Yevgeniy-Olexandrenko/tiny-rpn-calculator/hardware/pcb-rev1.x-keyboard/calculation.ods

Vcc | 5
Key | Vmeasure | ADC | Range | Range | Min | Max | Mid
HIGHEST | 4.5 | 921 | to next | to prev
KEY_D3 | 4.43 | 906 | 14 | 25 | 894 | 913 | 903
KEY_C3 | 4.31 | 882 | 25 | 35 | 864 | 893 | 879
KEY_B3 | 4.14 | 847 | 35 | 39 | 828 | 863 | 846
KEY_A3 | 3.95 | 808 | 39 | 90 | 763 | 827 | 795
KEY_D2 | 3.51 | 718 | 90 | 51 | 693 | 762 | 727
KEY_C2 | 3.26 | 667 | 51 | 61 | 636 | 692 | 664
KEY_B2 | 2.96 | 606 | 61 | 63 | 574 | 635 | 605
KEY_A2 | 2.65 | 542 | 63 | 72 | 506 | 573 | 540
KEY_D1 | 2.3 | 471 | 72 | 55 | 443 | 505 | 474
KEY_C1 | 2.03 | 415 | 55 | 63 | 384 | 442 | 413
KEY_B1 | 1.72 | 352 | 63 | 53 | 325 | 383 | 354
KEY_A1 | 1.46 | 299 | 53 | 57 | 270 | 324 | 297
KEY_D0 | 1.18 | 241 | 57 | 39 | 222 | 269 | 246
KEY_C0 | 0.99 | 203 | 39 | 39 | 183 | 221 | 202
KEY_B0 | 0.8 | 164 | 39 | 31 | 148 | 182 | 165
KEY_A0 | 0.65 | 133 | 31 | 31 | 118 | 147 | 132
LOWEST | 0.5 | 102
