Yevgeniy-Olexandrenko/tiny-rpn-calculator/hardware/pcb-rev1.4/Tiny-RPN-Calculator-rev1.4_BOM.tsv

ID | Name | Designator | Footprint | Quantity | Manufacturer Part | Manufacturer | Supplier | Supplier Part
1 | 1k | R4,R15,R10,R9 | R0603 | 4 | 0603WAF1001T5E | UniOhm | LCSC | C21190
2 | 51k | R14 | R0603 | 1 | 0603WAF5102T5E | UniOhm | LCSC | C23196
3 | 820R | R11 | R0603 | 1 | 0603WAF8200T5E | UniOhm | LCSC | C23253
4 | 560R | R12 | R0603 | 1 | 0603WAF5600T5E | UniOhm | LCSC | C23204
5 | 2k2 | R13 | R0603 | 1 | 0603WAF2201T5E | UniOhm | LCSC | C4190
6 | 680R | R5 | R0603 | 1 | 0603WAF6800T5E | UniOhm | LCSC | C23228
7 | 1k2 | R6 | R0603 | 1 | 0603WAF1201T5E | UniOhm | LCSC | C22765
8 | 3k3 | R7 | R0603 | 1 | 0603WAF3301T5E | UniOhm | LCSC | C22978
9 | 12k | R8 | R0603 | 1 | 0603WAF1202T5E | UniOhm | LCSC | C22790
10 | CHRG | LED | LED0603_RED | 1 | 19-217/R6C-AL1M2VY/3T | EVERLIGHT | LCSC | C72044
11 | 1u | C6,C5,C3,C4 | C0603 | 4 | CL10A105KB8NNNC | SAMSUNG | LCSC | C15849
12 | XC6206P332MR | U1 | SOT-23-3_L2.9-W1.6-P1.90-LS2.8-BR | 1 | XC6206P332MR | TOREX | LCSC | C5446
13 | U253-051N-4BH85-SB | USB | MICRO-USB-SMD_U253-051T-4BH85-SB | 1 | U253-051N-4BH85-SB | XKB Enterprise | LCSC | C319177
14 | MCP73831T-2ATI/OT | U2 | SOT-23-5_L3.0-W1.7-P0.95-LS2.8-BR | 1 | MCP73831T-2ATI/OT | MICROCHIP | LCSC | C14879
15 | DS3231MZ+ | RTC | SOIC-8_L4.9-W3.9-P1.27-LS6.0-BL | 1 | DS3231MZ+ | MAXIM | LCSC | C107410
16 | 100n | C7,C8 | C0603 | 2 | CC0603KRX7R9BB104 | YAGEO | LCSC | C14663
17 | 4u7 | C9,C10,C2 | C0603 | 3 | CL10A475KO8NNNC | SAMSUNG | LCSC | C19666
18 | 390k | R1 | R0603 | 1 | 0603WAF3903T5E | UniOhm | LCSC | C23150
19 | 4k7 | R2,R3 | R0603 | 2 | 0603WAF4701T5E | UniOhm | LCSC | C23162
20 | ATTINY85-20SU | MCU | SOIC-8_L5.3-W5.3-P1.27-LS8.0-BL | 1 | ATTINY85-20SU | MICROCHIP | LCSC | C89852
21 | 2u2 | C1 | C0603 | 1 | CL10A225KO8NNNC | SAMSUNG | LCSC | C23630
22 | SSD1306 128X32 | OLED | OLED-0.91 BARE | 1
23 | 3x6x2.5 | BTN_A0,BTN_A1,BTN_A2,BTN_A3,BTN_B0,BTN_B2,BTN_B3,BTN_B1,BTN_C0,BTN_C1,BTN_C2,BTN_C3,BTN_D0,BTN_D1,BTN_D2,BTN_D3 | KEY-3.0*6.0 | 16 | TS3625A-HT | SHOU HAN | LCSC | C412368
