Yevgeniy-Olexandrenko/tiny-rpn-calculator/documents/howto-build/howto-build.md

# How to Build the Business Card RPN Calculator with Watch

## Step 1 - TODO

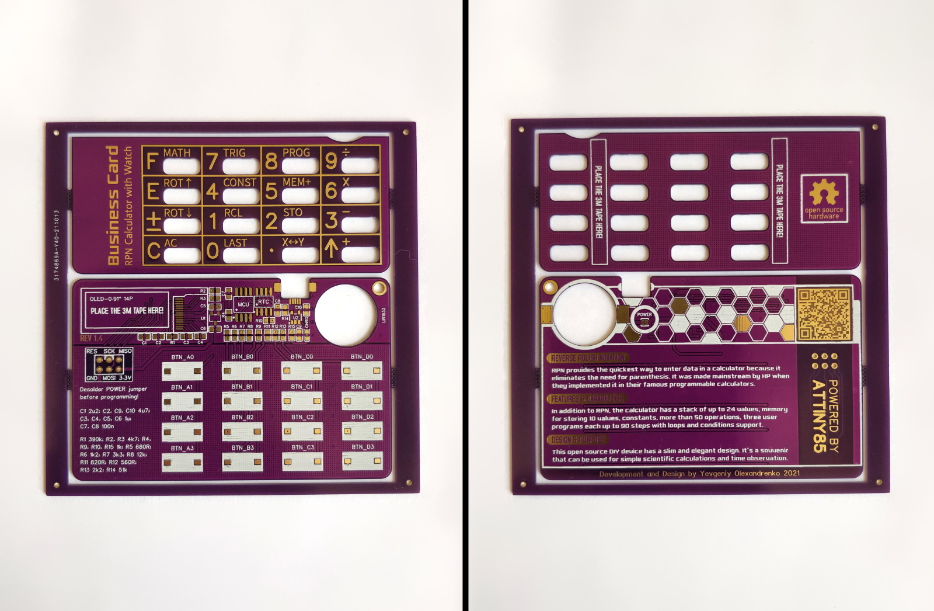
[picture p2: documents/howto-build/step1.jpg]
Step 1


## Step 2 - TODO

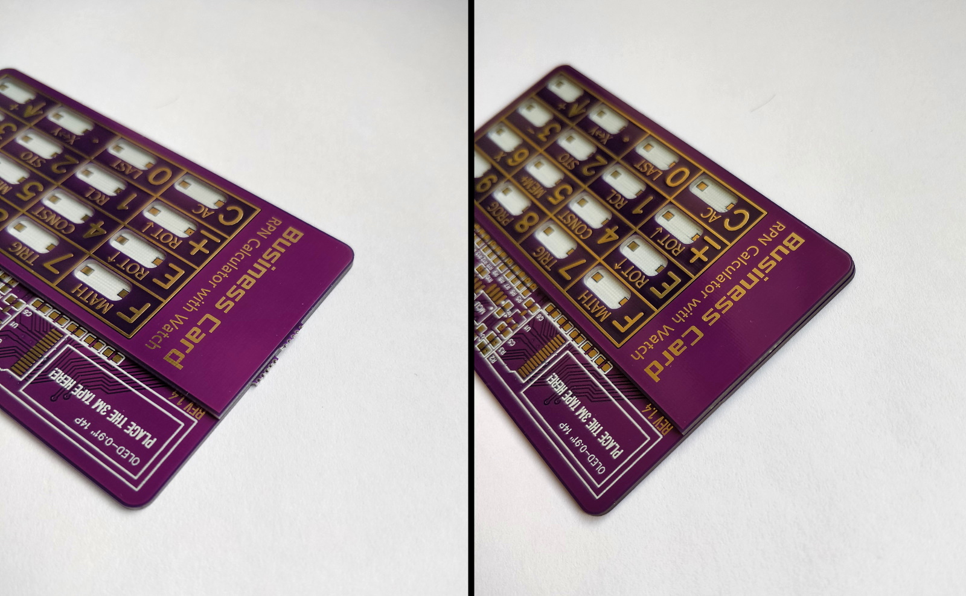
[picture p3: documents/howto-build/step2.jpg]
Step 2


## Step 3 - SMD Components

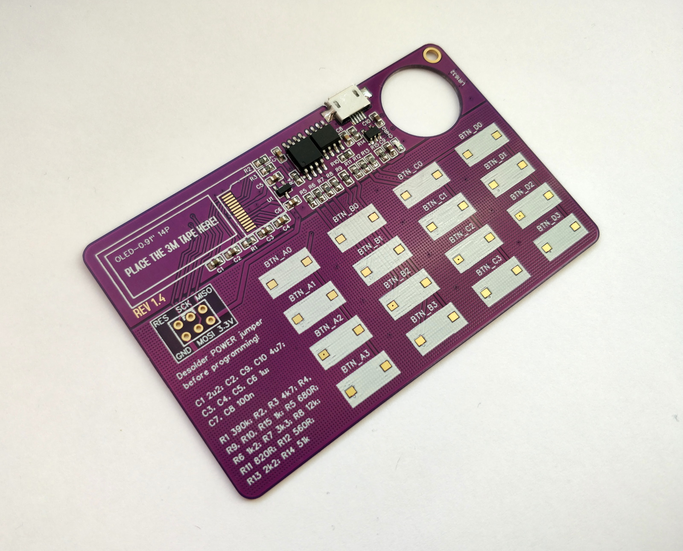
[picture p4: documents/howto-build/step3.jpg]
Step 3


## Step 4 - Buttons

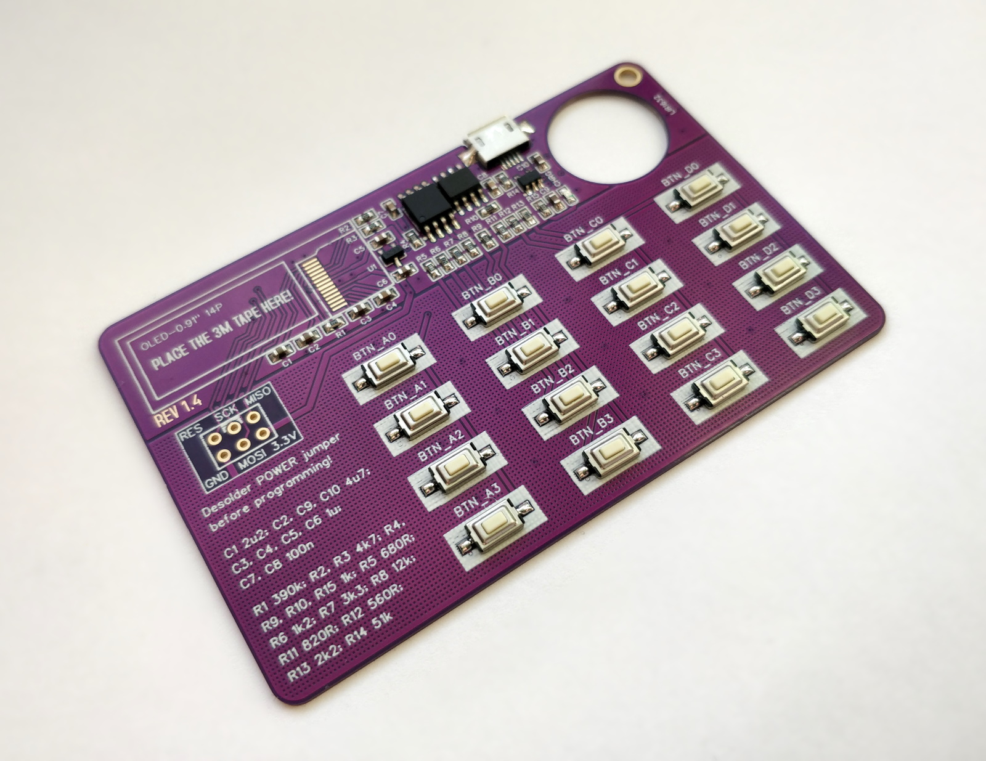
[picture p5: documents/howto-build/step4.jpg]
Step 4


## Step 5 - Battery

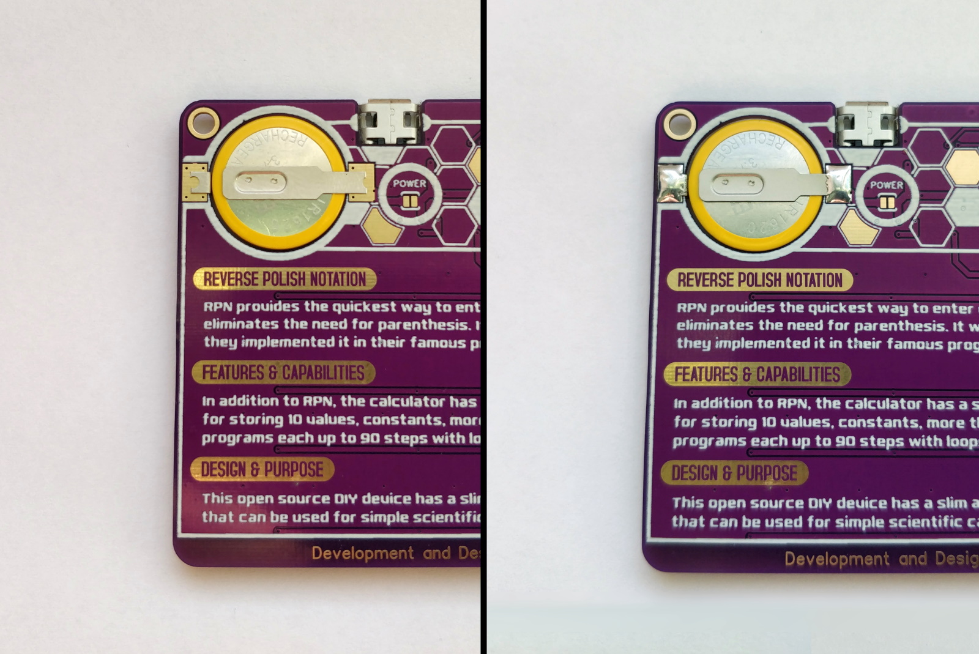
[picture p6: documents/howto-build/step5.jpg]
Step 5


## Step 6 - Display

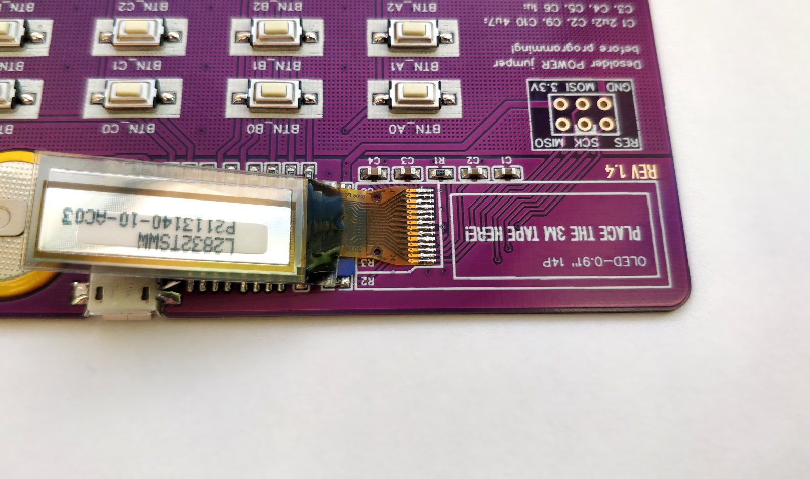
[picture p7: documents/howto-build/step6.jpg]
Step 6


## Step 7 - Ultra-thin 3M tape

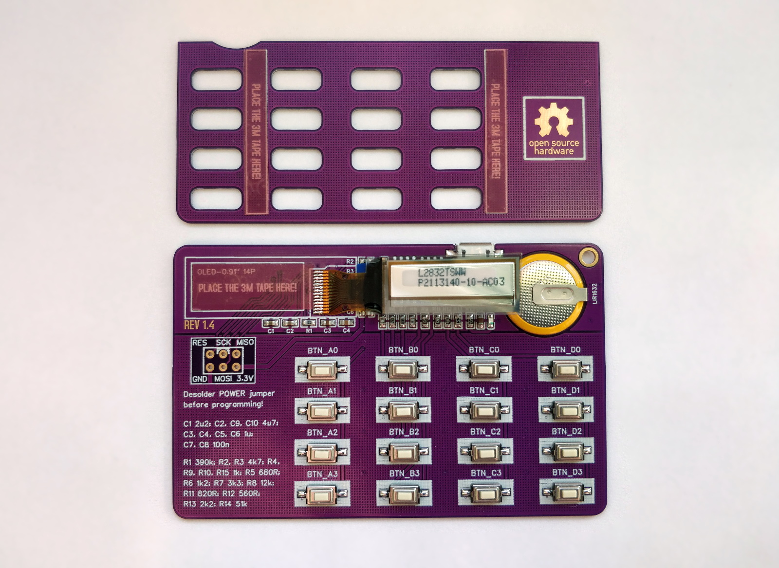
[picture p8: documents/howto-build/step7.jpg]
Step 7


## Step 8 - Programming

Write the firmware to the device. Refer to [HP-35 Firmware — User Manual](../manuals/hp35-firmware-user-manual.md#14-firmware-installation), section 14.

## Step 9 - Finished Device

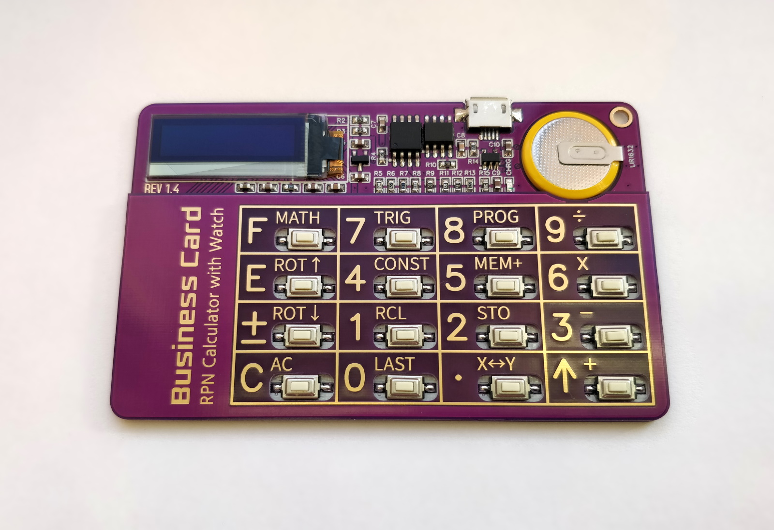
[picture p9: documents/howto-build/step9.jpg]
Step 9
