Yevgeniy-Olexandrenko/tiny-rpn-calculator/documents/manuals/images/hp35-device.jpg

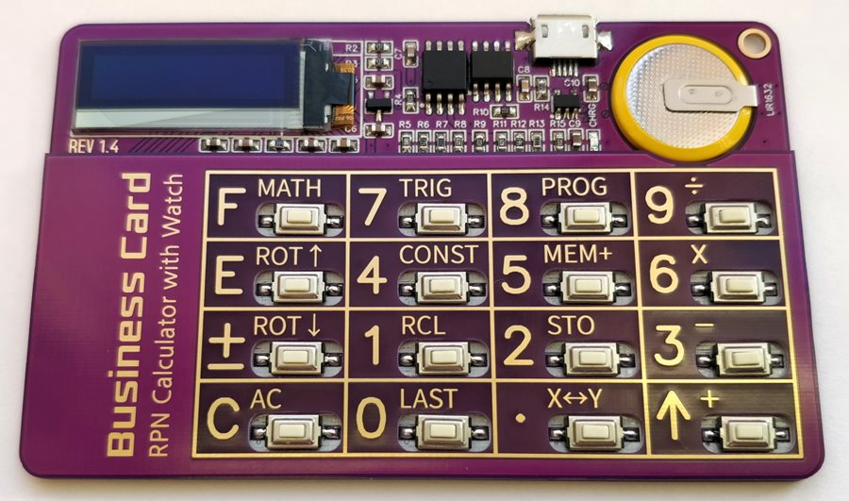
documents/manuals/images/hp35-device.jpg
