Yevgeniy-Olexandrenko/tiny-rpn-calculator/documents/manuals/images/hp35-keyboard.jpg

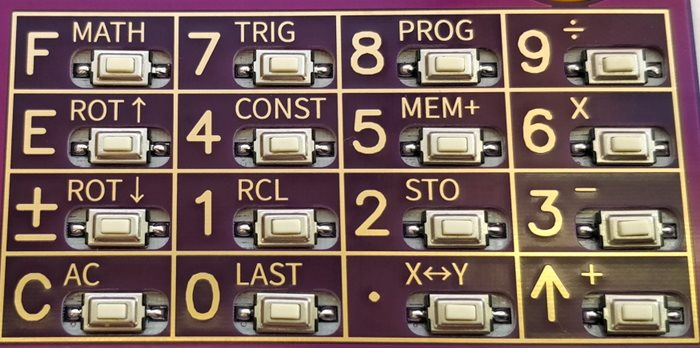
documents/manuals/images/hp35-keyboard.jpg
