Yevgeniy-Olexandrenko/tiny-rpn-calculator/hardware/pcb-rev1.5/Tiny-RPN-Calculator-rev1.5_Schematic.pdf

# Charger

# ICSP

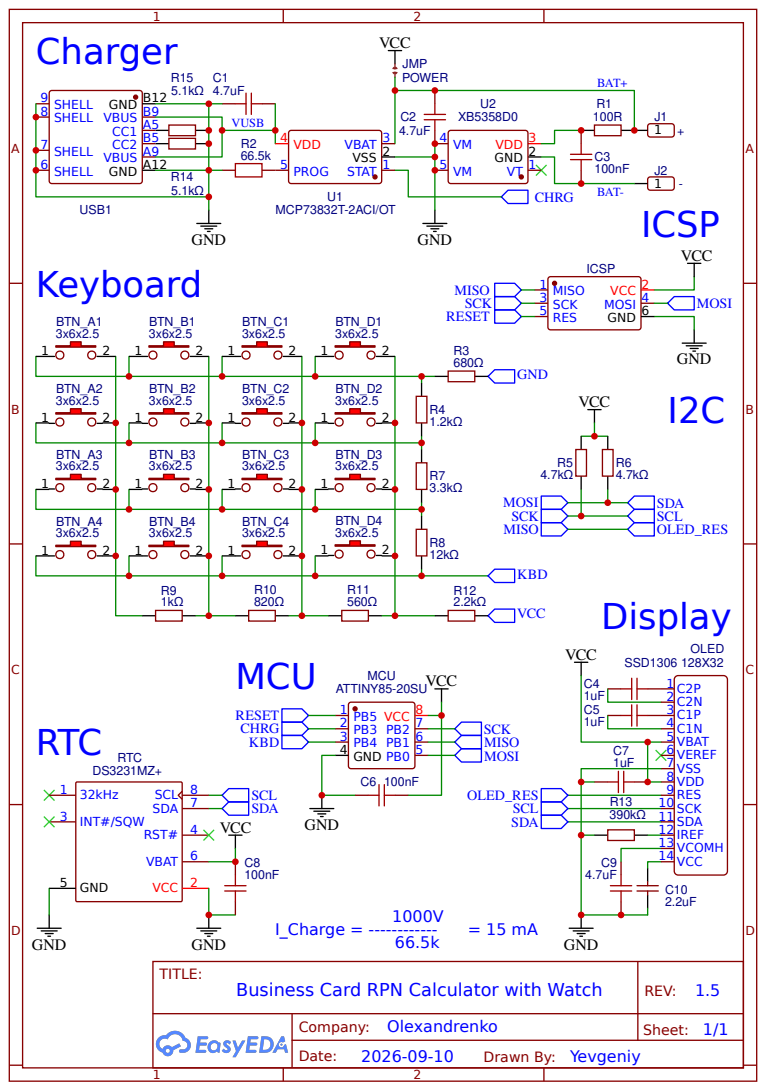
[picture p12: page 1]

STAT 1 VSS 2 VBAT 3 VDD 4
PROG 5 ⁶⁶.5k
