Yevgeniy-Olexandrenko/tiny-rpn-calculator/hardware/pcb-rev1.4/Tiny-RPN-Calculator-rev1.4_Schematic.pdf

# Keyboard

# Display

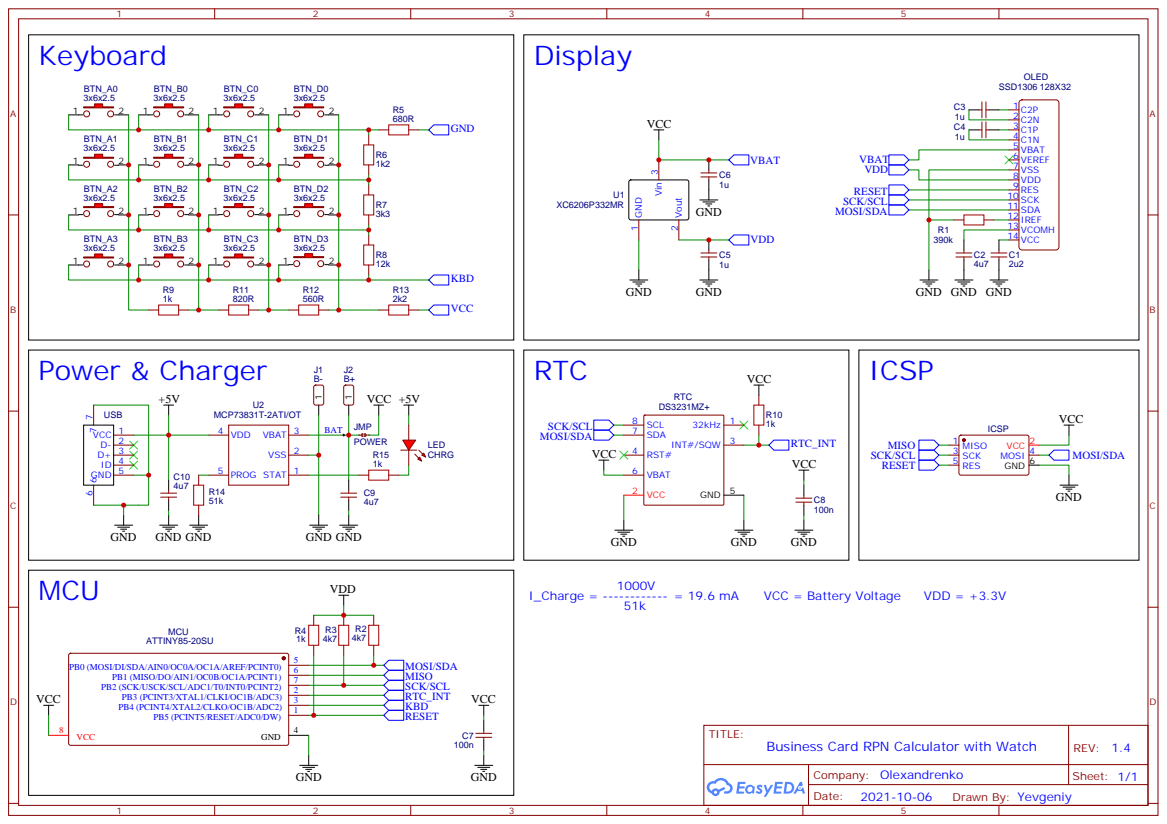
[picture p13: page 1]

PB0 (MOSI/DI/SDA/AIN0/OC0A/OC1A/AREF/PCINT0)
