Yevgeniy-Olexandrenko/tiny-rpn-calculator/hardware/pcb-rev1.3/Tiny-RPN-Calculator-rev1.3_Schematic.pdf

# Keyboard

# Display

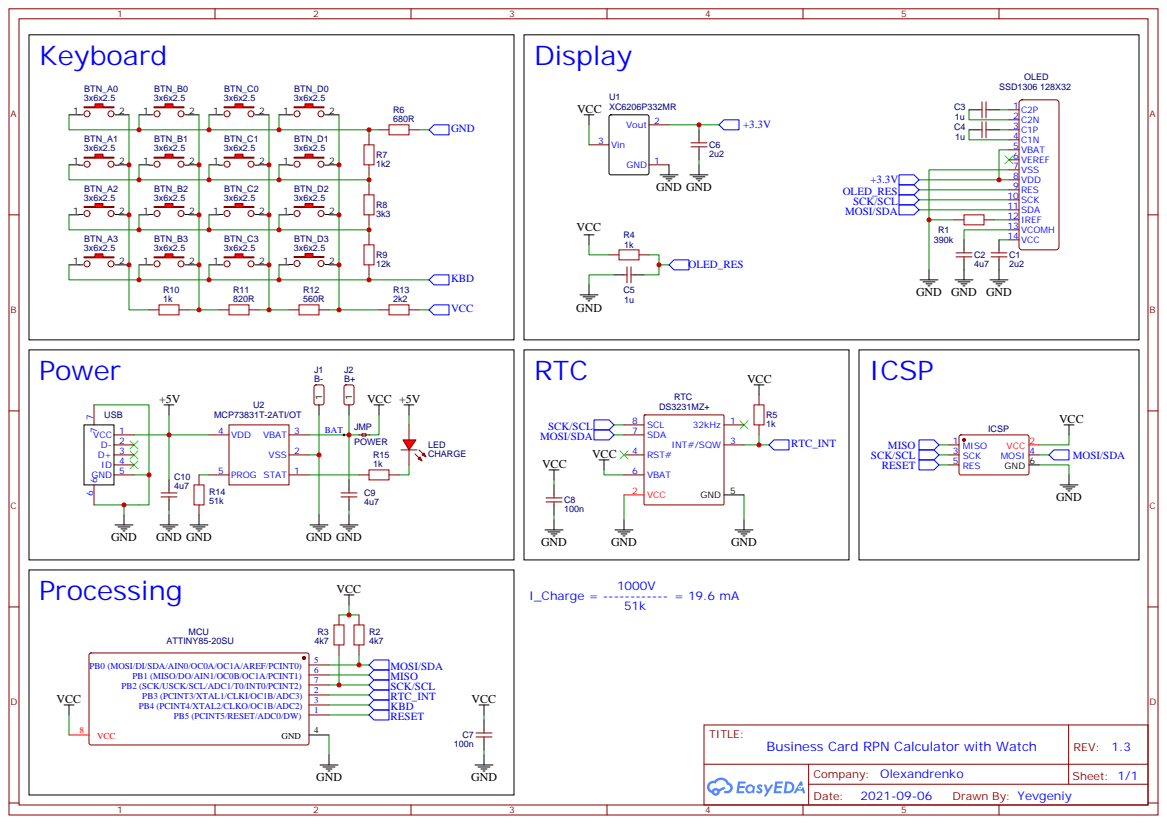
[picture p14: page 1]

PB0 (MOSI/DI/SDA/AIN0/OC0A/OC1A/AREF/PCINT0)
