Yevgeniy-Olexandrenko/tiny-rpn-calculator/(list of files, drawings)

Other design files:
hardware/pcb-rev1.x-keyboard/simulation.pdsprj
