Yevgeniy-Olexandrenko/tiny-rpn-calculator/firmware/sketches/hp21/code.h

#pragma once

// -----------------------------------------------------------------------------
// Working mode and keyboard input, shared by all modes
// -----------------------------------------------------------------------------

enum { MODE_RTC, MODE_CALC };
u08 mode;

u08 newKey;
u08 oldkey;

// slow mode (RTC) redraws every 512 ms only, so the mcu sleeps
// most of the time, while the keys are still read every frame
u08 slowPhase; // TMR::Millis / 512 at the last redraw, 0xFF forces one

b08 slowRedraw()
{
	u08 phase = u08(TMR::Millis >> 9);
	if (phase == slowPhase) return false;
	slowPhase = phase;
	return true;
}

// -----------------------------------------------------------------------------
// RTC mode
// -----------------------------------------------------------------------------

u08 battery;

void renderRTCMode()
{
	LCD::Clear();

	TXT::SetFont(digits7x32);
	TXT::PrintChar(RTC_TIME_COLON, RTC_POS_COLON_HM, 0);
	TXT::PrintChar(RTC_TIME_COLON, RTC_POS_COLON_MS, 0);
	TXT::PrintSegBCD(RTC::Hours,   RTC_POS_HOURS, 0);
	TXT::PrintSegBCD(RTC::Minutes, RTC_POS_MINUTES, 0);
	TXT::PrintSegBCD(RTC::Seconds, RTC_POS_SECONDS, 0);

	TXT::SetFont(menu5x8);
	u08 month = BCD::Decode(RTC::Month);
	TXT::PrintString(DPSTR(strMonth), month - 1, RTC_POS_MONTH, 0);
	TXT::PrintBCD(RTC::Date, RTC_POS_DATE, 0);
	TXT::PrintBCD(RTC::Year, RTC_POS_YEAR, 0);
	TXT::PrintChar(RTC_DATE_SLASH, RTC_POS_SLASH, 0);

	TXT::SetScale(TXT::x2, TXT::x1);
	TXT::PrintString(D(RTC_INFO_HP_LABEL), RTC_POS_INFO, 2);
	// blink the last bar while charging, toggling it every 512 ms,
	// with an empty battery one bar blinks
	u08 bars = battery;
	if ((TMR::Millis & 0x200) && PWR::Charging()) bars = (bars ? bars - 1 : 1);
	for (u08 i = bars, x = RTC_POS_INFO; i > 0; --i)
	{ 
		TXT::PrintChar(RTC_BATTERY_LEVEL, x, 1);
		TXT::NextPos(x);
	}

	LCD::Flip();
}

// returns false if a key is pressed to leave the mode
b08 updateRTCMode()
{
	if (newKey != KBD::NONE) return false;
	if (slowRedraw())
	{
		RTC::ReadTimeDate();
		renderRTCMode();
	}
	return true;
}

void enterRTCMode()
{
	battery = (u08)((PWR::Level() + 10U) / 20U); // 0..100% -> 0..5 bars

	SYS::Wake(TMR::TIMEOUT_64MS);

	oldkey    = KBD::Read();
	slowPhase = 0xFF;
	mode      = MODE_RTC;
}

NOINLINE
void setupAndEnterRTCMode()
{
	RTC::WriteTimeDate();
	enterRTCMode();
}

// -----------------------------------------------------------------------------
// Calculator mode
// -----------------------------------------------------------------------------

b08 isFunc;
b08 isMenu;
b08 isMem; // storage arithmetic: the next key selects the operation with M1
b08 powerOff; // OFF: power down in the next frame, the calculator starts again

Menu menu;
u08  select;

u16 cycles;
u08 hidden[sizeof(HPVM::Display)];
u08 lastOp = KEY_NOP; // nothing to repeat before the first menu or storage arithmetic operation

void enterMenu(u08 type)
{
	isMenu = true;
	MEM::ProgCopy(&menu, &menus[type], sizeof(Menu));
	select = 0;
}

void dropStack(u08 n)
{
	using namespace HPVM;
	// roll down via ROM to end number entry and refresh display,
	// then restore T to get a drop: C, Y, Z <- Y, Z, T
	do
	{
		OpAndWait(OpROT_);
		reg_move(T, Z, 0, 13, COPY);
	}
	while (--n);
}

b08 getBCD(const HPVM::reg& r, u08& out, u08 min, u08 max)
{
	// positive integer 0..999: mantissa sign, exponent sign and
	// exponent tens are zero, exponent units 0..2, digits of the
	// mantissa after the integer part are zero (no fraction)
	if ((r[13] | r[2] | r[1]) == 0 && r[0] < 3)
	{
		u08 last = 12 - r[0]; // the lowest digit of the integer part
		u16 value = 0;
		for (u08 i = 12; i > 2; --i)
		{
			if (i >= last)
				value = value * 16 + r[i];
			else if (r[i])
				return false;
		}
		if (value >= min && value <= max)
		{
			out = u08(value);
			return true;
		}
	}
	return false;
}

// the integer part of a number in the register layout: the digits of the
// mantissa after the decimal point are cleared, a number below 1 is zero
void truncate(HPVM::reg& r)
{
	// the exponent: sign digit r[2] (9 if negative), digits r[1] r[0]
	if (r[2])
		memset(r, 0, sizeof(HPVM::reg)); // below 1
	else if (!r[1])
		// exponent 0..9: the integer part has r[0] + 1 digits of 12..3
		for (u08 i = 11 - r[0]; i > 2; --i) r[i] = 0;
}

// lifts Y to Z, puts r into Y and lets the ROM do the operation with Y
// and X; the operation drops the stack again, so Y, Z, T do not change
// (T is kept by the drop, as it is a copy of Z after a division)
NOINLINE
void operationWithY(const HPVM::reg& r, u08 op)
{
	using namespace HPVM;
	memcpy(Z, Y, sizeof(reg));
	memcpy(Y, r, sizeof(reg));
	OpAndWait(op);
}

// Y mod X = Y - X * INT(Y / X), the ROM does the arithmetic, the sketch the
// integer part and the operands; the remainder gets the sign of X (as MOD of
// the HP-42S: -7 mod 3 = 2), the stack drops as after a division
void moduloYX()
{
	using namespace HPVM;
	reg x, y;
	memcpy(x, C, sizeof(reg));
	memcpy(y, Y, sizeof(reg));

	// for X = 0 the ROM shows the error of the division; Y / X of 10^9
	// or more has no digit after the decimal point in 10 digits, so the
	// remainder is lost
	OpAndWait(OpDIV_);
	if (!x[12]) return;
	if (!C[2] && (C[1] || C[0] >= 9))
	{
		Error();
		return;
	}

	truncate(C);
	operationWithY(x, OpMUL_);
	operationWithY(y, OpSUB_);
	if (C[12] && C[13] != x[13]) operationWithY(x, OpADD_);
}

void executeOperation(u08 operation)
{
	// the sketch reads and changes the registers of the VM directly,
	// so the previous operation must be finished first
	HPVM::WaitIdle();

	isFunc = false;
	isMenu = false;
	isMem  = false;
	// repeat the last menu or storage arithmetic operation, extended ones too
	if (operation == KEY_LAST) operation = lastOp;

	switch (operation)
	{
		default:
			// a constant of the CONST menu, otherwise a key of the ROM
			if (operation >= CONST_IN && operation <= CONST_E)
				HPVM::Constant(constants[CONST_E - operation]);
			else
				HPVM::Operation(operation);
			break;

		case KEY_FUNC:
			HPVM::DisplayY(hidden);
			isFunc = true;
			break;

		case KEY_MEM:
			isMem = true;
			break;

		case MEM_SWAP:
			// a number entered after it lifts the stack, as after RCL
			HPVM::ExchangeX(HPVM::M1);
			break;

		case MATH_SQR:
			// X * X, as ENTER and * on the HP-21: Y and Z are kept,
			// T gets a copy of Z
			HPVM::Operation(HPVM::OpPUSH);
			HPVM::Operation(HPVM::OpMUL_);
			break;

		case MATH_ROOT:
		{
			// Y ^ (1 / X); for X = 0 only 1/x, so the ROM shows its error,
			// Y ^ X of the ROM would continue after the error with 1.00;
			// X is normalized: it is zero if its first mantissa digit is
			b08 isZero = (HPVM::C[12] == 0);
			HPVM::Operation(HPVM::OpINV_);
			if (!isZero) HPVM::Operation(HPVM::OpPOW_);
			break;
		}

		case MATH_MOD:
			moduloYX();
			break;

		case KEY_ROTU:
			HPVM::Operation(HPVM::OpROT_);
			HPVM::Operation(HPVM::OpROT_);
			HPVM::Operation(HPVM::OpROT_);
			break;

		// DEG/RAD switch is wired to the F2 flag input
		case PROG_DEG:
			HPVM::F2 = false;
			break;

		case PROG_RAD:
			HPVM::F2 = true;
			break;

		case PROG_OFF:
			powerOff = true;
			break;

		case MENU_MATH:
		case MENU_TRIG:
		case MENU_PROG:
		case MENU_CONST:
			// the menu operations go down in the order of the menus
			enterMenu(MENU_MATH - operation);
			break;

		case PROG_TIME:
			// stack: X - seconds, Y - minutes, Z - hours, the values are
			// dropped if all are valid, otherwise the error is shown
			RTC::ReadTimeDate();
			if (getBCD(HPVM::C, RTC::Seconds, 0x00, 0x59) &&
			    getBCD(HPVM::Y, RTC::Minutes, 0x00, 0x59) &&
			    getBCD(HPVM::Z, RTC::Hours,   0x00, 0x23))
			{
				dropStack(3);
				setupAndEnterRTCMode();
			}
			else HPVM::Error();
			break;

		case PROG_DATE:
			// stack: X - year, Y - month, Z - date, the date is checked
			// against the days in the month, leap years included
			RTC::ReadTimeDate();
			if (getBCD(HPVM::C, RTC::Year,  0x00, 0x99) &&
			    getBCD(HPVM::Y, RTC::Month, 0x01, 0x12) &&
			    getBCD(HPVM::Z, RTC::Date,  0x01, 0x31) &&
			    BCD::Decode(RTC::Date) <= RTC::GetDaysInMonth())
			{
				dropStack(3);
				setupAndEnterRTCMode();
			}
			else HPVM::Error();
			break;

		case KEY_NOP:
			break;
	}
}

void renderCalcNumber(const u08 * segs, u08 y)
{
	// the exponent is in positions 9..11 (sign, 2 digits): then the sign
	// position is blank or a dash, a mantissa digit is never there; as on
	// hp35, the exponent is drawn by the small font in the last 3 cells
	u08 sign = segs[9];
	b08 isExp = (sign == TXT::SEG_SPACE || sign == TXT::SEG_DASH) && (segs[10] | segs[11]);

	// the dot is a part of the display position, but drawn as a separate char
	for (u08 i = 0, x = 0; i < sizeof(HPVM::Display); ++i)
	{
		if (i == 9 && isExp)
		{
			TXT::SetFont(digits7x16);
			x = CALC_POS_EXPONENT;
		}
		u08 seg = segs[i];
		TXT::PrintSeg(seg & ~TXT::SEG_DOT, x, y);
		TXT::NextPos(x);
		if (seg & TXT::SEG_DOT)
		{
			TXT::PrintSeg(TXT::SEG_DOT, x, y);
			TXT::NextPos(x);
		}
	}
}

void renderCalcMenu()
{
	TXT::SetFont(menu5x8);
	TXT::SetScale(TXT::x1, TXT::x2);
	TXT::SetInverse(true);
	for (u08 i = 0; i < MENU_ITEMS_PER_LINE; ++i)
	{
		TXT::PrintString(
			DPSTR(menu.string), select * MENU_ITEMS_PER_LINE + i,
			MENU_POS_ITEM * i, 2);
	}
	TXT::SetInverse(false);
}

void renderCalcMode()
{
	LCD::Clear();
	TXT::SetFont(digits7x16);

	// indicators at the right edge: the top place shows F, else S in the
	// storage arithmetic mode, else R, else S in a menu (the menu covers
	// the bottom place), the bottom place shows S out of these two modes
	b08 isStorage = false;
	for (u08 i = 0; i < sizeof(HPVM::M1); ++i)
	{
		if (HPVM::M1[i]) isStorage = true;
	}
	if (isFunc)
		TXT::PrintChar(FLAG_FUNCTION, FLAG_POS, 0);
	else if (isMem)
		TXT::PrintChar(FLAG_STORAGE, FLAG_POS, 0);
	else if (HPVM::F2)
		TXT::PrintChar(FLAG_RADIANS, FLAG_POS, 0);
	else if (isMenu && isStorage)
		TXT::PrintChar(FLAG_STORAGE, FLAG_POS, 0);
	if (!isMenu && !isMem && isStorage)
		TXT::PrintChar(FLAG_STORAGE, FLAG_POS, 2);

	if (isFunc)
	{
		renderCalcNumber(hidden, 0);
		renderCalcNumber(HPVM::Display, 2);
	}
	else if (isMenu)
	{
		renderCalcNumber(HPVM::Display, 0);
		renderCalcMenu();
	}
	else
	{
		TXT::SetFont(digits7x32);
		renderCalcNumber(HPVM::Display, 0);
	}
	
	LCD::Flip();
}

void updateCalcMode()
{
	if (newKey != KBD::NONE)
	{
		if (isMenu)
		{
			switch(newKey)
			{
				default: isMenu = false; break;
				case KBD::ROTU: if (select > 0) select--; else select = menu.lastIdx; break;
				case KBD::ROTD: if (select < menu.lastIdx) select++; else select = 0; break;
				case KBD::MATH: enterMenu(MENU_MATH_OPS); break;
				case KBD::TRIG: enterMenu(MENU_TRIG_OPS); break;
				case KBD::PROG: enterMenu(MENU_PROG_OPS); break;
				case KBD::CONS: enterMenu(MENU_CONST_OPS); break;
				case KBD::SEL1: case KBD::SEL2: case KBD::SEL3:
					u08 index = select * MENU_ITEMS_PER_LINE + (newKey - KBD::SEL1);
					u08 op = MEM::DataRead(menu.opsBase + index);
					executeOperation(lastOp = op);
					break;
			}
		}
		else if (isMem)
		{
			// the keys of the 4 arithmetic operations (shifted by F
			// otherwise) do them with the memory, the dot exchanges X and
			// the memory, any other key only leaves the mode
			isMem = false;
			u08 op = KEY_NOP;
			switch (newKey)
			{
				case KBD::NUM3: op = HPVM::OpMSUB; break;
				case KBD::NUM6: op = HPVM::OpMMUL; break;
				case KBD::NUM9: op = HPVM::OpMDIV; break;
				case KBD::DUP:  op = HPVM::OpMADD; break;
				case KBD::DOT:  op = MEM_SWAP;     break;
			}
			if (op != KEY_NOP) executeOperation(lastOp = op);
		}
		else
		{
			u08 op = MEM::DataRead(mainOps + (isFunc ? 16 : 0) + newKey);
			executeOperation(op);
		}
		renderCalcMode();
	}

	// the ROM runs also while a menu is open, so that it finishes the
	// calculation, local counter, unused cycles go to the next frame
	u16 n = cycles + HPVM_CYCLES_PER_FRAME;
	for (; n > 0; --n)
	{
		if (HPVM::Cycle())
		{
			renderCalcMode();
			break;
		}
	}
	cycles = n;
}

void enterCalcMode()
{
	mode = MODE_CALC;
	renderCalcMode();
}
// -----------------------------------------------------------------------------
// Enter point and main cycle
// -----------------------------------------------------------------------------

int main() 
{
	// init system hardware
	SYS::Init();

	// switch to rtc operation mode on reset
	setupAndEnterRTCMode();

	while (true)
	{
		// get time passed since last operation mode switch
		u16 timeout = TMR::Millis;

		// handle display contrast change
		LCD::Contrast(mode == MODE_RTC || timeout >= DIMOUT_MILLIS ? 0x00 : 0xFF);

		// handle power down condition: the timeout or OFF of the PROG menu
		if (timeout >= POWEROFF_MILLIS || powerOff)
		{
			// OFF clears the calculator, as the power-off of the original;
			// the DEG/RAD switch (F2) is kept
			if (powerOff)
			{
				HPVM::Reset();
				lastOp = KEY_NOP;
				powerOff = false;
			}

			// power down and go to sleeping
			SYS::Down();

			// power up and switch to rtc operation mode
			enterRTCMode();
		}

		// read key press, any key restarts the timeouts
		newKey = KBD::Read();
		if (newKey != oldkey) oldkey = newKey; else newKey = KBD::NONE;
		if (newKey != KBD::NONE) TMR::Start(TMR::TIMEOUT_64MS);

		// update current operation mode, switch it on a leaving key
		switch (mode)
		{
			case MODE_RTC:
				// any key goes to calculator
				if (!updateRTCMode()) enterCalcMode();
				break;

			default:
				updateCalcMode();
				break;
		}

		// idle until next frame
		TMR::Sync();
	}
	return 0;
}
