Yevgeniy-Olexandrenko/tiny-rpn-calculator/firmware/sketches/hp21/data.h

#pragma once

// -----------------------------------------------------------------------------
// Defines
// -----------------------------------------------------------------------------

#define CALC_FRAMES_PER_SEC   (15)
#define HPVM_CYCLES_PER_FRAME (HPVM::CYCLES_PER_SEC / CALC_FRAMES_PER_SEC)

#define FLAG_CHAR_W           (7)
#define FLAG_POS              (LCD::WIDTH - FLAG_CHAR_W)
#define FLAG_FUNCTION         'i'
#define FLAG_STORAGE          'j'
#define FLAG_RADIANS          'k'

// cells of a number as on hp35: the exponent after sign, 10 digits and dot
#define CALC_CHAR_W           (7 + 1)
#define CALC_POS_EXPONENT     (12 * CALC_CHAR_W)

#define MENU_CHAR_W           (5 + 1)
#define MENU_ITEM_W           ((1 + 4 + 1) * MENU_CHAR_W)
#define MENU_ITEMS_PER_LINE   (3)
#define MENU_SPACING          ((LCD::WIDTH - (MENU_ITEM_W * MENU_ITEMS_PER_LINE)) / (MENU_ITEMS_PER_LINE - 1))
#define MENU_POS_ITEM         (MENU_ITEM_W + MENU_SPACING)

#define RTC_TIME_CHAR_W       (7 + 1)
#define RTC_DATE_CHAR_W       (5 + 1)
#define RTC_TIME_COLON        'i'
#define RTC_DATE_SLASH        '/'
#define RTC_BATTERY_LEVEL     '='
#define RTC_INFO_HP_LABEL     "HP=21"

#define RTC_POS_HOURS         (0)
#define RTC_POS_COLON_HM      (2 * RTC_TIME_CHAR_W + RTC_POS_HOURS)
#define RTC_POS_MINUTES       (1 * RTC_TIME_CHAR_W + RTC_POS_COLON_HM)
#define RTC_POS_COLON_MS      (2 * RTC_TIME_CHAR_W + RTC_POS_MINUTES)
#define RTC_POS_SECONDS       (1 * RTC_TIME_CHAR_W + RTC_POS_COLON_MS)

#define RTC_POS_INFO          (72)
#define RTC_POS_MONTH         (RTC_POS_INFO)
#define RTC_POS_DATE          (3 * RTC_DATE_CHAR_W + RTC_POS_MONTH + 7)
#define RTC_POS_SLASH         (2 * RTC_DATE_CHAR_W + RTC_POS_DATE)
#define RTC_POS_YEAR          (1 * RTC_DATE_CHAR_W + RTC_POS_SLASH)

#define DIMOUT_MILLIS         (10000)
#define POWEROFF_MILLIS       (20000)

// -----------------------------------------------------------------------------
// Text fonts (menu, big digits, small digits)
// -----------------------------------------------------------------------------

const u08 menu5x8_bytes[] PROGMEM =
{
    // character '/' (0x2F)
    0x40, 0x20, 0x10, 0x08, 0x04,

    // character '0' (0x30)
    0x7E, 0x42, 0x42, 0x42, 0x7E,

    // character '1' (0x31)
    0x00, 0x02, 0x7E, 0x00, 0x00,

    // character '2' (0x32)
    0x72, 0x52, 0x52, 0x52, 0x5E,

    // character '3' (0x33)
    0x42, 0x4A, 0x4A, 0x4A, 0x7E,

    // character '4' (0x34)
    0x1E, 0x10, 0x10, 0x10, 0x7E,

    // character '5' (0x35)
    0x4E, 0x4A, 0x4A, 0x4A, 0x7A,

    // character '6' (0x36)
    0x7E, 0x4A, 0x4A, 0x4A, 0x7A,

    // character '7' (0x37)
    0x06, 0x02, 0x02, 0x02, 0x7E,

    // character '8' (0x38)
    0x7E, 0x4A, 0x4A, 0x4A, 0x7E,

    // character '9' (0x39)
    0x5E, 0x52, 0x52, 0x52, 0x7E,

    // character ':' (0x3A)
    0x00, 0x6C, 0x10, 0x6C, 0x00,

    // character ';' (0x3B)
    0x00, 0x5C, 0x50, 0x7C, 0x00,

    // character '<' (0x3C)
    0x36, 0x08, 0x36, 0x00, 0x00,

    // character '=' (0x3D)
    0x08, 0x08, 0x08, 0x08, 0x08,

    // character '>' (0x3E), a superscript 2 on hp21 (a superscript y on hp35)
    0x3A, 0x2A, 0x2E, 0x00, 0x00,

    // character '?' (0x3F)
    0x10, 0x20, 0x7E, 0x02, 0x02,

    // character '@' (0x40)
    0x00, 0x7C, 0x54, 0x5C, 0x00,

    // character 'A' (0x41)
    0x7E, 0x12, 0x12, 0x12, 0x7E,

    // character 'B' (0x42)
    0x7E, 0x4A, 0x4A, 0x4E, 0x78,

    // character 'C' (0x43)
    0x7E, 0x42, 0x42, 0x42, 0x42,

    // character 'D' (0x44)
    0x7E, 0x42, 0x42, 0x42, 0x3C,

    // character 'E' (0x45)
    0x7E, 0x4A, 0x4A, 0x4A, 0x42,

    // character 'F' (0x46)
    0x7E, 0x0A, 0x0A, 0x0A, 0x02,

    // character 'G' (0x47)
    0x7E, 0x42, 0x4A, 0x4A, 0x7A,

    // character 'H' (0x48)
    0x7E, 0x08, 0x08, 0x08, 0x7E,

    // character 'I' (0x49)
    0x42, 0x42, 0x7E, 0x42, 0x42,

    // character 'J' (0x4A)
    0x70, 0x40, 0x40, 0x40, 0x7E,

    // character 'K' (0x4B)
    0x7E, 0x08, 0x08, 0x14, 0x62,

    // character 'L' (0x4C)
    0x7E, 0x40, 0x40, 0x40, 0x40,

    // character 'M' (0x4D)
    0x7E, 0x02, 0x1E, 0x02, 0x7C,

    // character 'N' (0x4E)
    0x7E, 0x02, 0x02, 0x02, 0x7C,

    // character 'O' (0x4F)
    0x7E, 0x42, 0x42, 0x42, 0x7E,

    // character 'P' (0x50)
    0x7E, 0x12, 0x12, 0x12, 0x1E,

    // character 'Q' (0x51)
    0x7E, 0x42, 0x52, 0x62, 0x7E,

    // character 'R' (0x52)
    0x7E, 0x12, 0x12, 0x32, 0x5E,

    // character 'S' (0x53)
    0x4E, 0x4A, 0x4A, 0x4A, 0x7A,

    // character 'T' (0x54)
    0x02, 0x02, 0x7E, 0x02, 0x02,

    // character 'U' (0x55)
    0x7E, 0x40, 0x40, 0x40, 0x7E,

    // character 'V' (0x56)
    0x1E, 0x20, 0x40, 0x20, 0x1E,

    // character 'W' (0x57)
    0x7E, 0x20, 0x10, 0x20, 0x7E,

    // character 'X' (0x58)
    0x62, 0x14, 0x08, 0x14, 0x62,

    // character 'Y' (0x59)
    0x4E, 0x48, 0x48, 0x48, 0x7E,

    // character 'Z' (0x5A)
    0x62, 0x52, 0x4A, 0x4A, 0x46,
};

const TXT::Font menu5x8 PROGMEM =
{
    .bytesInRow  = 0x05,
    .rowsOfBytes = 0x01,
    .asciiFirst  = 0x2F,
    .asciiLast   = 0x5A,
    .bytes = menu5x8_bytes // 220 bytes
};

const u08 digits7x32_bytes[] PROGMEM =
{
    // character 'a' (0x61)
    0x00, 0x02, 0x02, 0x02, 0x02, 0x02, 0x00,
    0x00, 0x00, 0x00, 0x00, 0x00, 0x00, 0x00,
    0x00, 0x00, 0x00, 0x00, 0x00, 0x00, 0x00,
    0x00, 0x00, 0x00, 0x00, 0x00, 0x00, 0x00,

    // character 'b' (0x62)
    0x00, 0x00, 0x00, 0x00, 0x00, 0x00, 0xFC,
    0x00, 0x00, 0x00, 0x00, 0x00, 0x00, 0x7F,
    0x00, 0x00, 0x00, 0x00, 0x00, 0x00, 0x00,
    0x00, 0x00, 0x00, 0x00, 0x00, 0x00, 0x00,

    // character 'c' (0x63)
    0x00, 0x00, 0x00, 0x00, 0x00, 0x00, 0x00,
    0x00, 0x00, 0x00, 0x00, 0x00, 0x00, 0x00,
    0x00, 0x00, 0x00, 0x00, 0x00, 0x00, 0xFF,
    0x00, 0x00, 0x00, 0x00, 0x00, 0x00, 0x1F,

    // character 'd' (0x64)
    0x00, 0x00, 0x00, 0x00, 0x00, 0x00, 0x00,
    0x00, 0x00, 0x00, 0x00, 0x00, 0x00, 0x00,
    0x00, 0x00, 0x00, 0x00, 0x00, 0x00, 0x00,
    0x00, 0x20, 0x20, 0x20, 0x20, 0x20, 0x00,

    // character 'e' (0x65)
    0x00, 0x00, 0x00, 0x00, 0x00, 0x00, 0x00,
    0x00, 0x00, 0x00, 0x00, 0x00, 0x00, 0x00,
    0xFF, 0x00, 0x00, 0x00, 0x00, 0x00, 0x00,
    0x1F, 0x00, 0x00, 0x00, 0x00, 0x00, 0x00,

    // character 'f' (0x66)
    0xFC, 0x00, 0x00, 0x00, 0x00, 0x00, 0x00,
    0x7F, 0x00, 0x00, 0x00, 0x00, 0x00, 0x00,
    0x00, 0x00, 0x00, 0x00, 0x00, 0x00, 0x00,
    0x00, 0x00, 0x00, 0x00, 0x00, 0x00, 0x00,

    // character 'g' (0x67)
    0x00, 0x00, 0x00, 0x00, 0x00, 0x00, 0x00,
    0x00, 0x80, 0x80, 0x80, 0x80, 0x80, 0x00,
    0x00, 0x00, 0x00, 0x00, 0x00, 0x00, 0x00,
    0x00, 0x00, 0x00, 0x00, 0x00, 0x00, 0x00,

    // character 'h' (0x68)
    0x00, 0x00, 0x00, 0x00, 0x00, 0x00, 0x00,
    0x00, 0x00, 0x00, 0x00, 0x00, 0x00, 0x00,
    0x00, 0x00, 0x00, 0x00, 0x00, 0x00, 0x00,
    0x00, 0x00, 0x1C, 0x1C, 0x1C, 0x00, 0x00,

    // character 'i' (0x69)
    0x00, 0x00, 0x00, 0x00, 0x00, 0x00, 0x00,
    0x00, 0x00, 0x07, 0x07, 0x07, 0x00, 0x00,
    0x00, 0x00, 0x70, 0x70, 0x70, 0x00, 0x00,
    0x00, 0x00, 0x00, 0x00, 0x00, 0x00, 0x00,
};

const TXT::Font digits7x32 PROGMEM =
{
    .bytesInRow  = 0x07,
    .rowsOfBytes = 0x04,
    .asciiFirst  = 0x61,
    .asciiLast   = 0x69,
    .bytes = digits7x32_bytes // 252 bytes
};

const u08 digits7x16_bytes[] PROGMEM =
{
    // character 'a' (0x61)
    0x00, 0x02, 0x02, 0x02, 0x02, 0x02, 0x00,
    0x00, 0x00, 0x00, 0x00, 0x00, 0x00, 0x00,

    // character 'b' (0x62)
    0x00, 0x00, 0x00, 0x00, 0x00, 0x00, 0x7C,
    0x00, 0x00, 0x00, 0x00, 0x00, 0x00, 0x00,

    // character 'c' (0x63)
    0x00, 0x00, 0x00, 0x00, 0x00, 0x00, 0x00,
    0x00, 0x00, 0x00, 0x00, 0x00, 0x00, 0x1F,

    // character 'd' (0x64)
    0x00, 0x00, 0x00, 0x00, 0x00, 0x00, 0x00,
    0x00, 0x20, 0x20, 0x20, 0x20, 0x20, 0x00,

    // character 'e' (0x65)
    0x00, 0x00, 0x00, 0x00, 0x00, 0x00, 0x00,
    0x1F, 0x00, 0x00, 0x00, 0x00, 0x00, 0x00,

    // character 'f' (0x66)
    0x7C, 0x00, 0x00, 0x00, 0x00, 0x00, 0x00,
    0x00, 0x00, 0x00, 0x00, 0x00, 0x00, 0x00,

    // character 'g' (0x67)
    0x00, 0x80, 0x80, 0x80, 0x80, 0x80, 0x00,
    0x00, 0x00, 0x00, 0x00, 0x00, 0x00, 0x00,

    // character 'h' (0x68)
    0x00, 0x00, 0x00, 0x00, 0x00, 0x00, 0x00,
    0x00, 0x00, 0x18, 0x18, 0x18, 0x00, 0x00,

    // character 'i' (0x69)
    0xFE, 0x02, 0x02, 0x72, 0x72, 0xF2, 0xFE,
    0x3F, 0x20, 0x20, 0x3E, 0x3E, 0x3F, 0x3F,

    // character 'j' (0x6A)
    0xFE, 0x86, 0x02, 0x32, 0x32, 0x72, 0xFE,
    0x3F, 0x27, 0x27, 0x27, 0x20, 0x30, 0x3F,

    // character 'k' (0x6B)
    0xFE, 0x02, 0x02, 0x32, 0x02, 0x86, 0xFE,
    0x3F, 0x20, 0x20, 0x3F, 0x20, 0x20, 0x3F,
};

const TXT::Font digits7x16 PROGMEM =
{
    .bytesInRow  = 0x07,
    .rowsOfBytes = 0x02,
    .asciiFirst  = 0x61,
    .asciiLast   = 0x6B,
    .bytes = digits7x16_bytes // 154 bytes
};

// -----------------------------------------------------------------------------
// HP21 Operations (basic + extended)
// -----------------------------------------------------------------------------

enum
{
	BASE = 0xFF,
	KEY_NOP    = BASE - 0,
	KEY_FUNC   = BASE - 1,
	KEY_LAST   = BASE - 2,
	KEY_ROTU   = BASE - 3,
	MENU_MATH  = BASE - 4,
	MENU_TRIG  = BASE - 5,
	MENU_PROG  = BASE - 6,
	MENU_CONST = BASE - 7,
	PROG_RAD   = BASE - 8,
	PROG_DEG   = BASE - 9,
	PROG_TIME  = BASE - 10,
	PROG_DATE  = BASE - 11,
	KEY_MEM    = BASE - 12,
	PROG_OFF   = BASE - 13,
	CONST_E    = BASE - 14, // the constants go down in the order of constants[]
	CONST_G    = BASE - 15,
	CONST_C    = BASE - 16,
	CONST_H    = BASE - 17,
	CONST_QE   = BASE - 18,
	CONST_D2R  = BASE - 19,
	CONST_MI   = BASE - 20,
	CONST_IN   = BASE - 21,
	MATH_SQR   = BASE - 22,
	MATH_ROOT  = BASE - 23,
	MATH_MOD   = BASE - 24,
	MEM_SWAP   = BASE - 25
};

const u08 mainOps[] DATAMEM =
{
	// main operations
	HPVM::OpNUM0, HPVM::OpNUM1, HPVM::OpNUM2, HPVM::OpNUM3, HPVM::OpNUM4, HPVM::OpNUM5, HPVM::OpNUM6, HPVM::OpNUM7,
	HPVM::OpNUM8, HPVM::OpNUM9, HPVM::OpDOT_, HPVM::OpPUSH, HPVM::OpCLX_, HPVM::OpCHS_, HPVM::OpEEX_, KEY_FUNC,

	// F-shifted operations
	KEY_LAST,     HPVM::OpRCL_, HPVM::OpSTO_, HPVM::OpSUB_, MENU_CONST,   KEY_MEM,      HPVM::OpMUL_, MENU_TRIG,
	MENU_PROG,    HPVM::OpDIV_, HPVM::OpSWAP, HPVM::OpADD_, HPVM::OpCLR_, HPVM::OpROT_, KEY_ROTU,     MENU_MATH
};

const u08 mathOps[] DATAMEM =
{
	MATH_SQR,     HPVM::OpSQRT, HPVM::OpINV_,
	HPVM::OpPOW_, MATH_ROOT,    MATH_MOD,
	HPVM::OpEXP_, HPVM::Op10X_, HPVM::Op2POL,
	HPVM::OpLN__, HPVM::OpLOG_, HPVM::Op2REC
};

const u08 trigOps[] DATAMEM =
{
	HPVM::OpSIN_, HPVM::OpCOS_, HPVM::OpTAN_,
	HPVM::OpASIN, HPVM::OpACOS, HPVM::OpATAN
};

const u08 progOps[] DATAMEM =
{
	HPVM::OpDSP_, PROG_RAD,  PROG_DEG,
	PROG_TIME,    PROG_DATE, PROG_OFF
};

const u08 constOps[] DATAMEM =
{
	HPVM::OpPI__, CONST_E,   CONST_G,
	CONST_C,      CONST_H,   CONST_QE,
	CONST_D2R,    CONST_MI,  CONST_IN
};

// -----------------------------------------------------------------------------
// Constants in the register layout of X: mantissa sign, 10 digits of the
// mantissa, exponent sign and 2 digits (a negative exponent is 1000 - e)
// -----------------------------------------------------------------------------

const u08 constants[][7] PROGMEM =
{
	{ 0x02, 0x71, 0x82, 0x81, 0x82, 0x80, 0x00 }, // e  = 2.718281828
	{ 0x09, 0x80, 0x66, 0x50, 0x00, 0x00, 0x00 }, // g  = 9.80665 m/s^2 (standard gravity, exact)
	{ 0x02, 0x99, 0x79, 0x24, 0x58, 0x00, 0x08 }, // c  = 2.99792458E8 m/s (speed of light, exact)
	{ 0x06, 0x62, 0x60, 0x70, 0x15, 0x09, 0x66 }, // h  = 6.62607015E-34 J s (Planck constant, exact)
	{ 0x01, 0x60, 0x21, 0x76, 0x63, 0x49, 0x81 }, // qe = 1.602176634E-19 C (elementary charge, exact)
	{ 0x01, 0x74, 0x53, 0x29, 0x25, 0x29, 0x98 }, // pi / 180 = 1.745329252E-2 (degrees to radians)
	{ 0x01, 0x60, 0x93, 0x44, 0x00, 0x00, 0x00 }, // 1.609344 (miles to kilometers, exact)
	{ 0x02, 0x54, 0x00, 0x00, 0x00, 0x00, 0x01 }, // 25.4 (inches to millimeters, exact)
};

static_assert(CONST_E - CONST_IN + 1 == sizeof(constants) / sizeof(constants[0]),
	"executeOperation() finds the constant as CONST_E - operation");

// -----------------------------------------------------------------------------
// String arrays
// -----------------------------------------------------------------------------

const u08 strMonth[] DATAMEM =
	"\03"
	"JAN" "FEB" "MAR" "APR" "MAY" "JUN"
	"JUL" "AUG" "SEP" "OCT" "NOV" "DEC";

const u08 strMenuMath[] DATAMEM =
	"\06"
	" :>   " " ?:   " " 1/:  "  // X^2 ('>' is a superscript 2), SQRT(X), 1/X
	" ;<   " " <?;  " " MOD  "   // Y^X, X-th root of Y, Y modulo X
	" @<   " " 10<  " " POL  "   // e^X, 10^X, To polar
	" LN   " " LOG  " " REC  "; // LN(X), LOG(X), To rectangular

const u08 strMenuTrig[] DATAMEM = 
	"\06"
	" SIN  " " COS  " " TAN  "  // Sine, Cosine, Tangent
	" ASIN " " ACOS " " ATAN "; // Inverse sine, Inverse cosine, Inverse tangent

const u08 strMenuProg[] DATAMEM =
	"\06"
	" DSP  " " RAD  " " DEG  "  // Display format (DSP n: SCI, DSP . n: FIX), angle mode
	" TIME " " DATE " " OFF  "; // Set clock time (H M S), date (D M Y), power off with reset

const u08 strMenuConst[] DATAMEM =
	"\06"
	" PI   " " E    " " G    "  // Pi, e, standard gravity
	" C    " " H    " " QE   "   // Speed of light, Planck constant, elementary charge
	" D=R  " " MILE " " INCH "; // Degrees to radians ('=' is a dash), km in a mile, mm in an inch

// -----------------------------------------------------------------------------
// Menu structures
// -----------------------------------------------------------------------------

struct Menu
{
	u08 lastIdx;
	const u08 * string;
	const u08 * opsBase;
};

const Menu menus[] PROGMEM =
{
	{ sizeof(mathOps)  / MENU_ITEMS_PER_LINE - 1, strMenuMath,  mathOps  },
	{ sizeof(trigOps)  / MENU_ITEMS_PER_LINE - 1, strMenuTrig,  trigOps  },
	{ sizeof(progOps)  / MENU_ITEMS_PER_LINE - 1, strMenuProg,  progOps  },
	{ sizeof(constOps) / MENU_ITEMS_PER_LINE - 1, strMenuConst, constOps },
};

enum { MENU_MATH_OPS, MENU_TRIG_OPS, MENU_PROG_OPS, MENU_CONST_OPS };

static_assert(MENU_MATH - MENU_TRIG == MENU_TRIG_OPS && MENU_MATH - MENU_PROG == MENU_PROG_OPS &&
	MENU_MATH - MENU_CONST == MENU_CONST_OPS, "executeOperation() finds the menu as MENU_MATH - operation");
