Yevgeniy-Olexandrenko/tiny-rpn-calculator/firmware/sketches/hp21/hp21.ino

// -----------------------------------------------------------------------------
// Emulator for HP-21 Calculator
// -----------------------------------------------------------------------------

#define  ENABLE_OPT_DATAMEM  1
#define  ENABLE_OPT_NOINLINE 1
#define  PCB_REVISION        14 // 14 - PCB rev 1.3/1.4, 15 - PCB rev 1.5

#include <TinyRPNCalculator.h>
#include <Extras/HP21Model.h>
#include <Extras/HPVMWoodstock.h>

#include "data.h"
#include "code.h"

// Reference compilation output (PCB_REVISION 14, with 15 the sketch uses 7496 bytes):
// Sketch uses 7480 bytes (91%) of program storage space. Maximum is 8192 bytes.
// Global variables use 241 bytes (47%) of dynamic memory, leaving 271 bytes for local variables. Maximum is 512 bytes.
