Yevgeniy-Olexandrenko/tiny-rpn-calculator/(commit log)

2021-06-21 Added keyboard research files, fixed keyboard values in code
    [calculation.ods, simulation.pdsprj]
2021-07-02 Fixed RPN flow
2021-07-03 Fixed huge RAM usage
    [calc_operations.h]
2021-07-05 Reduced power consumption
2021-07-13 Fixes and new implementation
    [calc_mainloop.h, calc_operations.h]
2021-08-09 Added device photo
2021-08-10 Modified for pcb 1.x support
2021-08-10 Added support for retrieving temperature from RTC
2021-08-10 Fixed temperature calculation
2021-08-10 Added implementation for 'bit banging i2c' (wip)
2021-08-11 Added datasheet for battery
2021-08-11 Improved power management
2021-08-12 Improved power management + refactoring
2021-08-12 Added passed time count for power saving features
2021-08-15 Added battery discharge protection
2021-08-15 Added implementation for 'bit banging i2c' for code size reduction
2021-08-15 Added extra firmwares suitable for this pcb (wip)
2021-08-15 Added battery level indicator
2021-08-16 Clean up + fixes + code size reduction
    [calc_mainloop.h, calc_operations.h, calc_textfont.h, calculator.ino, hw_support.h]
2021-08-17 Remove old implementation for i2c bus
2021-08-18 Replace operation DROP implementation with operation CLR one + saved space
    [calc_mainloop.h, calc_operations.h]
2021-09-17 Updated to burn to device
    [calc_mainloop.h, calculator.ino]
2021-09-19 Potentially reduced power consumption in RTC mode
2021-09-25 New implementation for ADC
2021-09-25 Fixed battery level displaying
2021-09-29 Refactoring + ADC optimization
2021-10-09 Added hp calculators firmwares
    [11c.obj, 12c.obj, 15c.obj, 16c.obj, 21.obj, 25.obj, 32e.obj, 33c.obj]
2021-10-11 Move printing functions to hardware lib
2021-10-12 Added schematic and files for PCB production
    [Tiny-RPN-Calculator-rev1.3_BOM.csv, Tiny-RPN-Calculator-rev1.3_PickAndPlace.csv]
2021-10-16 Fixed text drawing in hw lib + added new fonts to hp35 fw
    [data.h]
2021-10-16 Fixed rtc mode displaying
    [data.h]
2021-10-19 Remove useless files
    [11c.obj, 12c.obj, 15c.obj, 16c.obj, 21.obj, 25.obj, 32e.obj, 33c.obj]
2021-10-20 Added more hardware documentation
    [Tiny-RPN-Calculator-rev1.3_BOM.csv, Tiny-RPN-Calculator-rev1.3_PickAndPlace.csv, calculation.ods, simulation.pdsprj]
2021-10-24 Fixed HP virtual machine + refactoring
    [firmware.ino, lib_hpvm_classic.h]
2021-11-08 Added fabrication files for pcb rev1.4
    [Tiny-RPN-Calculator-rev1.4_BOM.csv, Tiny-RPN-Calculator-rev1.4_PickAndPlace.csv]
2021-11-08 Added pcb rev1.4 photo
2023-02-01 Update bom file format
    [Tiny-RPN-Calculator-rev1.3_BOM.tsv, Tiny-RPN-Calculator-rev1.4_BOM.tsv]
2026-08-07 Fixed non-obvious hardware init
    [code.h]
2026-08-07 Improvements and bug fixes in I2C module
2026-09-05 Added support for Arduino Maker Workshop in VSCode
2026-09-05 Improved ADC reading and reduced power consumption
2026-09-05 Fixed ADC thresholds + flash optimizations
2026-09-05 Add calculation of ADC thresholds based on resistor values
2026-09-06 Optimizations in I2C communication with display
2026-09-08 Replace FPS module with new TMR implementation
    [code.h]
2026-10-17 Added support for pcb rev1.5
2026-10-17 Change charge blinking period
2026-10-17 Fixed TOTP calculations + reduced power consumption
2026-10-21 Fixed the peripheral power consumption
2026-10-21 Improved charging animation + fix in example sketch
2026-10-21 Added HP-21 power off operation
